zavorka/Twonkie/hw/3d/632712000011.stp

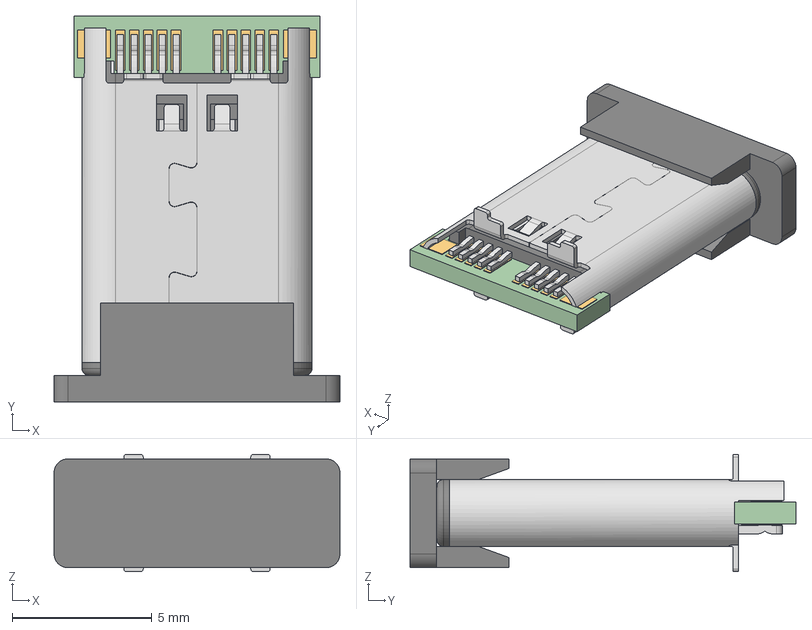
[picture p1: CAD file, 2022-02-24]
hw/3d/632712000011.stp
10.2 x 13.8 x 4.20 mm
632712000011_Housing
632712000011_Housing1
632712000011_Housing2
632712000011_Pin2
632712000011_Pin1 x 22
632712000011_Contact x 2
632712000011_CAP
632712000011_Layout
632712000011_Shielding
