zavorka/Twonkie/hw/twonkie.kicad_pcb

## KiCad design hw/twonkie.kicad_pcb (2022-02-24)

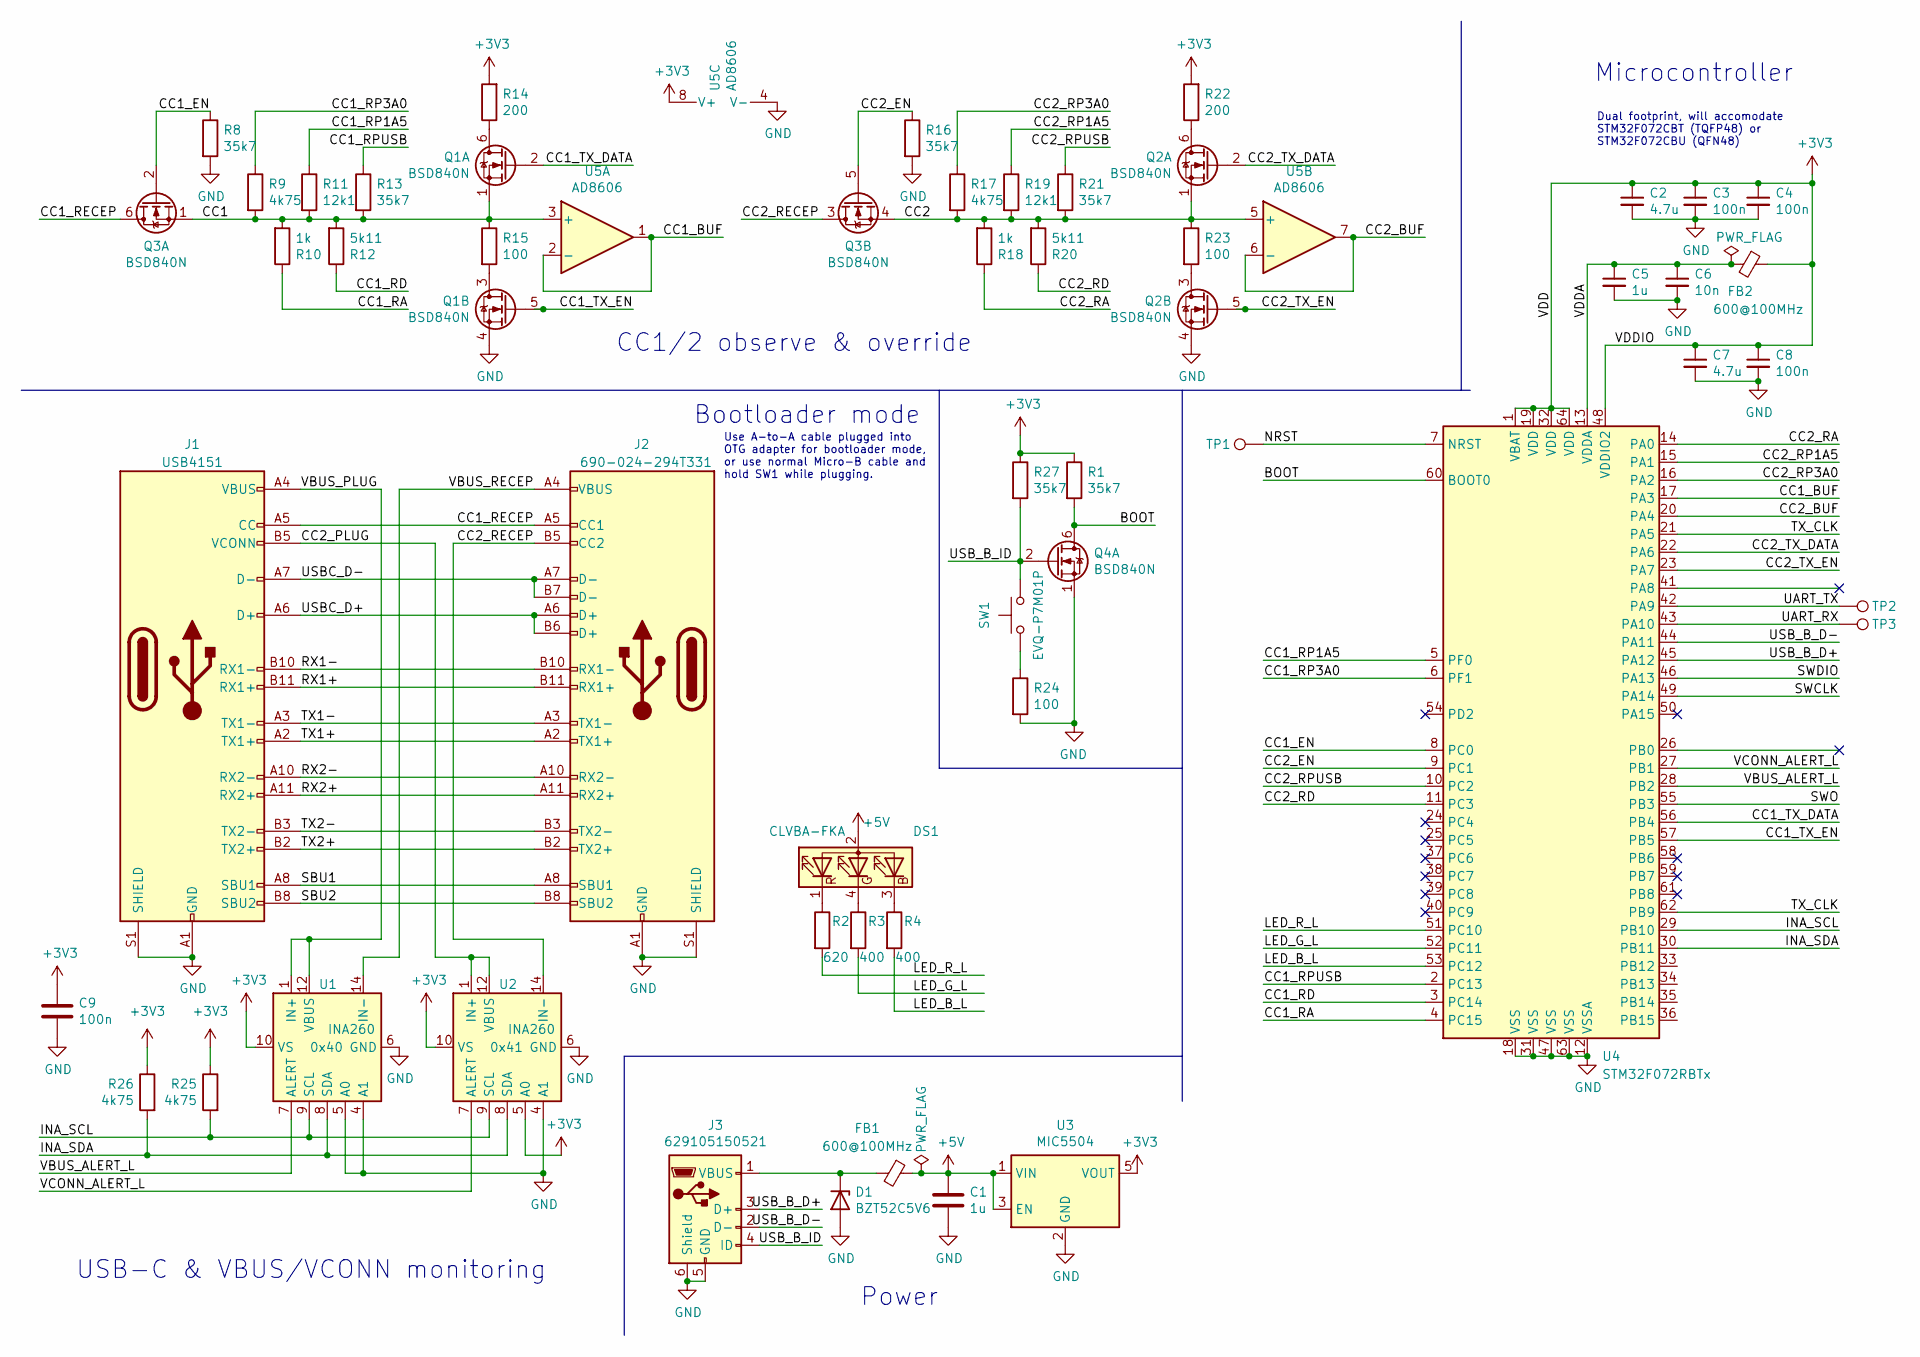
[picture p2: schematic twonkie.kicad_sch]

Parts:
C1, C5: 1u; C_0402_1005Metric; Mfg P/N CL05A105MQ5NNNC; DigiKey P/N 1276-1235-1-ND
C2, C7: 4.7u; C_0402_1005Metric; Mfg P/N CL05A475KQ5NRNC; DigiKey P/N 1276-1481-1-ND
C3, C4, C8, C9: 100n; C_0402_1005Metric; Mfg P/N CL05B104KA5NNNC; DigiKey P/N 1276-6720-1-ND
C6: 10n; C_0402_1005Metric; Mfg P/N CL05B103KB5NNNC; DigiKey P/N 1276-1028-1-ND
D1: BZT52C5V6; D_SOD-123; Mfg P/N BZT52C5V6-13-F; DigiKey P/N BZT52C5V6-13-FDICT-ND
DS1: CLVBA-FKA; LED_Cree-PLCC4_3.2x2.8mm_CCW; Mfg P/N CLVBA-FKA-CAEDH8BBB7A363; DigiKey P/N CLVBA-FKA-CAEDH8BBB7A363CT-ND
FB1, FB2: 600@100MHz; L_0402_1005Metric; Mfg P/N BLM15AG601SN1D; DigiKey P/N 490-1006-1-ND
J1: USB4151; USB_C_Plug_Wurth_632712000011; Mfg P/N USB4151-GF-C; DigiKey P/N 2073-USB4151-GF-CCT-ND
J2: 690-024-294T331; USB_C_Receptacle_Amphenol_12401548E4-2A; Mfg P/N 690-024-294T331; DigiKey P/N 151-1601-1-ND
J3: 629105150521; USB_Micro-B_Wuerth_629105150521; Mfg P/N 629105150521; DigiKey P/N 732-5960-1-ND
Q1, Q2, Q3, Q4: BSD840N; SOT-363_SC-70-6; Mfg P/N BSD840NH6327XTSA1; DigiKey P/N BSD840NH6327XTSA1CT-ND
R1, R8, R13, R16, R21, R27: 35k7; R_0402_1005Metric; Mfg P/N RC0402FR-0735K7L
R2: 620; R_0402_1005Metric; Mfg P/N RC0402FR-07620RL
R3, R4: 400; R_0402_1005Metric; Mfg P/N RC0402FR-07402RL
R9, R17, R25, R26: 4k75; R_0402_1005Metric; Mfg P/N RC0402FR-074K75L
R10, R18: 1k; R_0402_1005Metric; Mfg P/N RC0402FR-071KL
R11, R19: 12k1; R_0402_1005Metric; Mfg P/N RC0402FR-0712K1L
R12, R20: 5k11; R_0402_1005Metric; Mfg P/N RC0402FR-075K11L
R14, R22: 200; R_0402_1005Metric; Mfg P/N RC0402FR-07200RL
R15, R23, R24: 100; R_0402_1005Metric; Mfg P/N RC0402FR-07100RL
SW1: EVQ-P7M01P; SW_SPST_EVQP7C; Mfg P/N EVQ-P7M01P; DigiKey P/N P16770CT-ND
TP1, TP2, TP3: TestPoint; TestPoint_Pad_D1.0mm
U1, U2: INA260; TSSOP-16_4.4x5mm_P0.65mm; Mfg P/N INA260AIPWR; DigiKey P/N 296-47777-1-ND
U3: MIC5504; SOT-23-5; Mfg P/N MIC5504-3.3YM5-TR; DigiKey P/N 576-4764-1-ND
U4: STM32F072RBTx; LQFP-64_10x10mm_P0.5mm
U5: AD8606; MSOP-8_3x3mm_P0.65mm; Mfg P/N AD8606ARMZ-REEL; DigiKey P/N AD8606ARMZREELCT-ND

Connections:
+3V3: C2.1, C3.1, C4.1, C7.1, C8.1, C9.1, FB2.1, R1.1, R14.2, R22.2, R25.1, R26.1, R27.1, U1.10 (VS), U2.5 (A0), U2.10 (VS), U3.5 (VOUT), U4.1 (VBAT), U4.19 (VDD), U4.32 (VDD), U4.48 (VDDIO2), U4.64 (VDD), U5.8 (V+)
+5V: C1.1, DS1.2 (A), FB1.1, U3.1 (VIN), U3.3 (EN)
/BOOT: Q4.6 (D), R1.2, U4.60 (BOOT0)
/CC1: Q1.1 (S), Q3.1 (S), R9.2, R10.2, R11.2, R12.2, R13.2, R15.1, U5.3 (+)
/CC1_BUF: U4.17 (PA3), U5.1, U5.2 (-)
/CC1_EN: Q3.2 (G), R8.1, U4.8 (PC0)
/CC1_RA: R10.1, U4.4 (PC15)
/CC1_RD: R12.1, U4.3 (PC14)
/CC1_RECEP: J1.A5 (CC), J2.A5 (CC1), Q3.6 (D)
/CC1_RP1A5: R11.1, U4.5 (PF0)
/CC1_RP3A0: R9.1, U4.6 (PF1)
/CC1_RPUSB: R13.1, U4.2 (PC13)
/CC1_TX_DATA: Q1.2 (G), U4.56 (PB4)
/CC1_TX_EN: Q1.5 (G), U4.57 (PB5)
/CC2: Q2.1 (S), Q3.4 (S), R17.2, R18.2, R19.2, R20.2, R21.2, R23.1, U5.5 (+)
/CC2_BUF: U4.20 (PA4), U5.6 (-), U5.7
/CC2_EN: Q3.5 (G), R16.1, U4.9 (PC1)
/CC2_PLUG: J1.B5 (VCONN), U2.1 (IN+), U2.2 (IN+), U2.3 (IN+), U2.12 (VBUS)
/CC2_RA: R18.1, U4.14 (PA0)
/CC2_RD: R20.1, U4.11 (PC3)
/CC2_RECEP: J2.B5 (CC2), Q3.3 (D), U2.14 (IN-), U2.15 (IN-), U2.16 (IN-)
/CC2_RP1A5: R19.1, U4.15 (PA1)
/CC2_RP3A0: R17.1, U4.16 (PA2)
/CC2_RPUSB: R21.1, U4.10 (PC2)
/CC2_TX_DATA: Q2.2 (G), U4.22 (PA6)
/CC2_TX_EN: Q2.5 (G), U4.23 (PA7)
/INA_SCL: R25.2, U1.9 (SCL), U2.9 (SCL), U4.29 (PB10)
/INA_SDA: R26.2, U1.8 (SDA), U2.8 (SDA), U4.30 (PB11)
/LED_B_L: R4.2, U4.53 (PC12)
/LED_G_L: R3.2, U4.52 (PC11)
/LED_R_L: R2.2, U4.51 (PC10)
/NRST: TP1.1, U4.7 (NRST)
/RX1+: J1.B11 (RX1+), J2.B11 (RX1+)
/RX1-: J1.B10 (RX1-), J2.B10 (RX1-)
/RX2+: J1.A11 (RX2+), J2.A11 (RX2+)
/RX2-: J1.A10 (RX2-), J2.A10 (RX2-)
/SBU1: J1.A8 (SBU1), J2.A8 (SBU1)
/SBU2: J1.B8 (SBU2), J2.B8 (SBU2)
/SWCLK: U4.49 (PA14)
/SWDIO: U4.46 (PA13)
/SWO: U4.55 (PB3)
/TX1+: J1.A2 (TX1+), J2.A2 (TX1+)
/TX1-: J1.A3 (TX1-), J2.A3 (TX1-)
/TX2+: J1.B2 (TX2+), J2.B2 (TX2+)
/TX2-: J1.B3 (TX2-), J2.B3 (TX2-)
/TX_CLK: U4.21 (PA5), U4.62 (PB9)
/UART_RX: TP3.1, U4.43 (PA10)
/UART_TX: TP2.1, U4.42 (PA9)
/USBC_D+: J1.A6 (D+), J2.A6 (D+), J2.B6 (D+)
/USBC_D-: J1.A7 (D-), J2.A7 (D-), J2.B7 (D-)
/USB_B_D+: J3.3 (D+), U4.45 (PA12)
/USB_B_D-: J3.2 (D-), U4.44 (PA11)
/USB_B_ID: J3.4 (ID), Q4.2 (G), R27.2, SW1.1
/VBUS_ALERT_L: U1.7 (ALERT), U4.28 (PB2)
/VBUS_PLUG: J1.A4 (VBUS), J1.A9 (VBUS), J1.B4 (VBUS), J1.B9 (VBUS), U1.1 (IN+), U1.2 (IN+), U1.3 (IN+), U1.12 (VBUS)
/VBUS_RECEP: J2.A4 (VBUS), J2.A9 (VBUS), J2.B4 (VBUS), J2.B9 (VBUS), U1.14 (IN-), U1.15 (IN-), U1.16 (IN-)
/VCONN_ALERT_L: U2.7 (ALERT), U4.27 (PB1)
/VDDA: C5.1, C6.1, FB2.2, U4.13 (VDDA)
GND: C1.2, C2.2, C3.2, C4.2, C5.2, C6.2, C7.2, C8.2, C9.2, D1.2 (A), J1.A1 (GND), J1.A12 (GND), J1.B1 (GND), J1.B12 (GND), J1.S1 (SHIELD), J1.S2 (SHIELD), J1.S3 (SHIELD), J1.S4 (SHIELD), J1.S5 (SHIELD), J1.S6 (SHIELD), J2.A1 (GND), J2.A12 (GND), J2.B1 (GND), J2.B12 (GND), J2.S1 (SHIELD), J2.S2 (SHIELD), J2.S3 (SHIELD), J2.S4 (SHIELD), J2.S5 (SHIELD), J2.S6 (SHIELD), J2.S7 (SHIELD), J2.S8 (SHIELD), J3.5 (GND), J3.6 (Shield), Q1.4 (S), Q2.4 (S), Q4.1 (S), R8.2, R16.2, R24.2, U1.4 (A1), U1.5 (A0), U1.6 (GND), U1.11 (GND), U2.4 (A1), U2.6 (GND), U2.11 (GND), U3.2 (GND), U4.12 (VSSA), U4.18 (VSS), U4.31 (VSS), U4.47 (VSS), U4.63 (VSS), U5.4 (V-)
unnamed: D1.1 (K), FB1.2, J3.1 (VBUS)
unnamed: DS1.1 (RK), R2.1
unnamed: DS1.3 (BK), R4.1
unnamed: DS1.4 (GK), R3.1
unnamed: Q1.3 (D), R15.2
unnamed: Q1.6 (D), R14.1
unnamed: Q2.3 (D), R23.2
unnamed: Q2.6 (D), R22.1
unnamed: R24.1, SW1.2

Notes on the sheet:
Bootloader mode
Dual footprint, will accomodate STM32F072CBT (TQFP48) or STM32F072CBU (QFN48)
Power
Use A-to-A cable plugged into OTG adapter for bootloader mode, or use normal Micro-B cable and hold SW1 while plugging.
Microcontroller
USB-C & VBUS/VCONN monitoring
CC1/2 observe & override

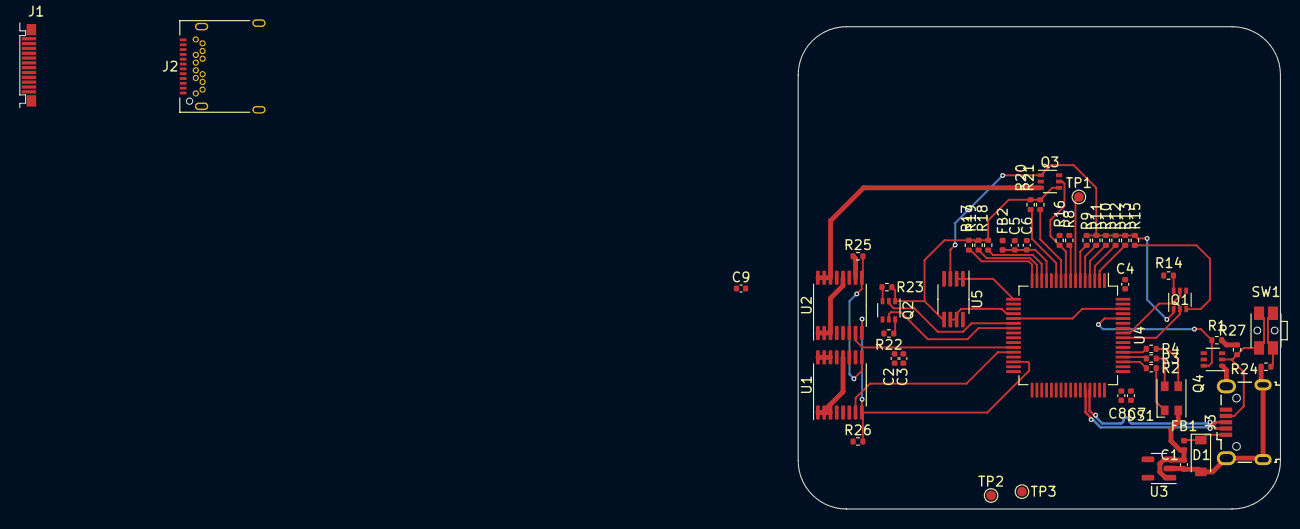
[picture p3: board twonkie.kicad_pcb from above]

Board: 4 copper layers, 50.0 x 50.0 mm, 53 parts (0 on the bottom side), 65 nets.
