zavorka/Twonkie/fw/chip/stm32/config-stm32f10x.h

/* Copyright (c) 2013 The Chromium OS Authors. All rights reserved.
 * Use of this source code is governed by a BSD-style license that can be
 * found in the LICENSE file.
 */

/* Memory mapping */
#define CONFIG_FLASH_SIZE 0x00020000
#define CONFIG_FLASH_BANK_SIZE  0x1000
#define CONFIG_FLASH_ERASE_SIZE 0x0400  /* erase bank size */
#define CONFIG_FLASH_WRITE_SIZE 0x0002  /* minimum write size */

/* No page mode on STM32F, so no benefit to larger write sizes */
#define CONFIG_FLASH_WRITE_IDEAL_SIZE 0x0002

#define CONFIG_RAM_BASE         0x20000000
#define CONFIG_RAM_SIZE         0x00005000

/* Number of IRQ vectors on the NVIC */
#define CONFIG_IRQ_COUNT 60

/* Use DMA for UART receive */
#define CONFIG_UART_RX_DMA

/* Fake hibernate mode */
#define CONFIG_STM32L_FAKE_HIBERNATE

/* USB packet ram config */
#define CONFIG_USB_RAM_BASE        0x40006000
#define CONFIG_USB_RAM_SIZE        512
#define CONFIG_USB_RAM_ACCESS_TYPE uint32_t
#define CONFIG_USB_RAM_ACCESS_SIZE 4
